jacobhuesman/Localization-Cape/README.md

# bbb_localization_cape
BeagleBone Black Cape for Localization Project
