jacobhuesman/Localization-Cape/eagle/localization-daughter-board.pdf

# Dynamixel LDO Microcontroller

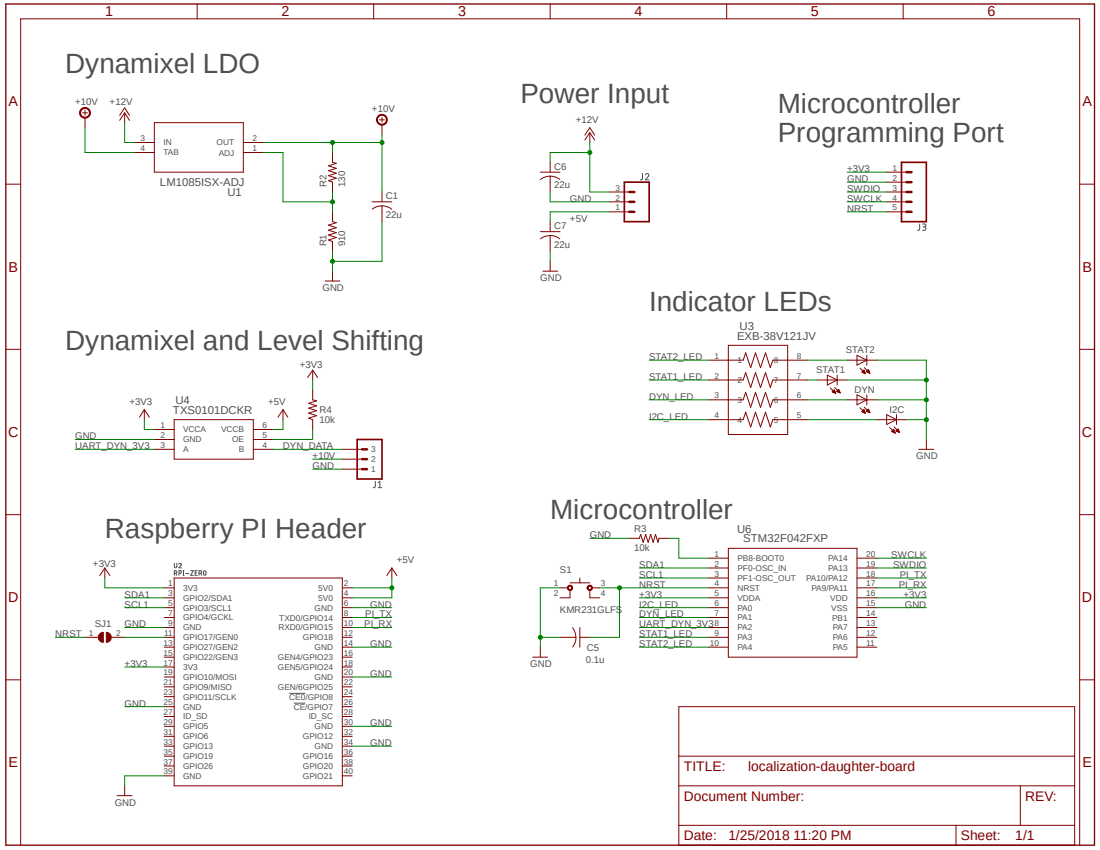
[picture p1: page 1]

Dynamixel and Level Shifting

Document Number: | REV:

Date: 1/25/2018 11:20 PM | Sheet: 1/1
