jacobhuesman/Localization-Cape/eagle/localization-daughter-board.brd

## EAGLE design eagle/localization-daughter-board.brd (2018-01-27)

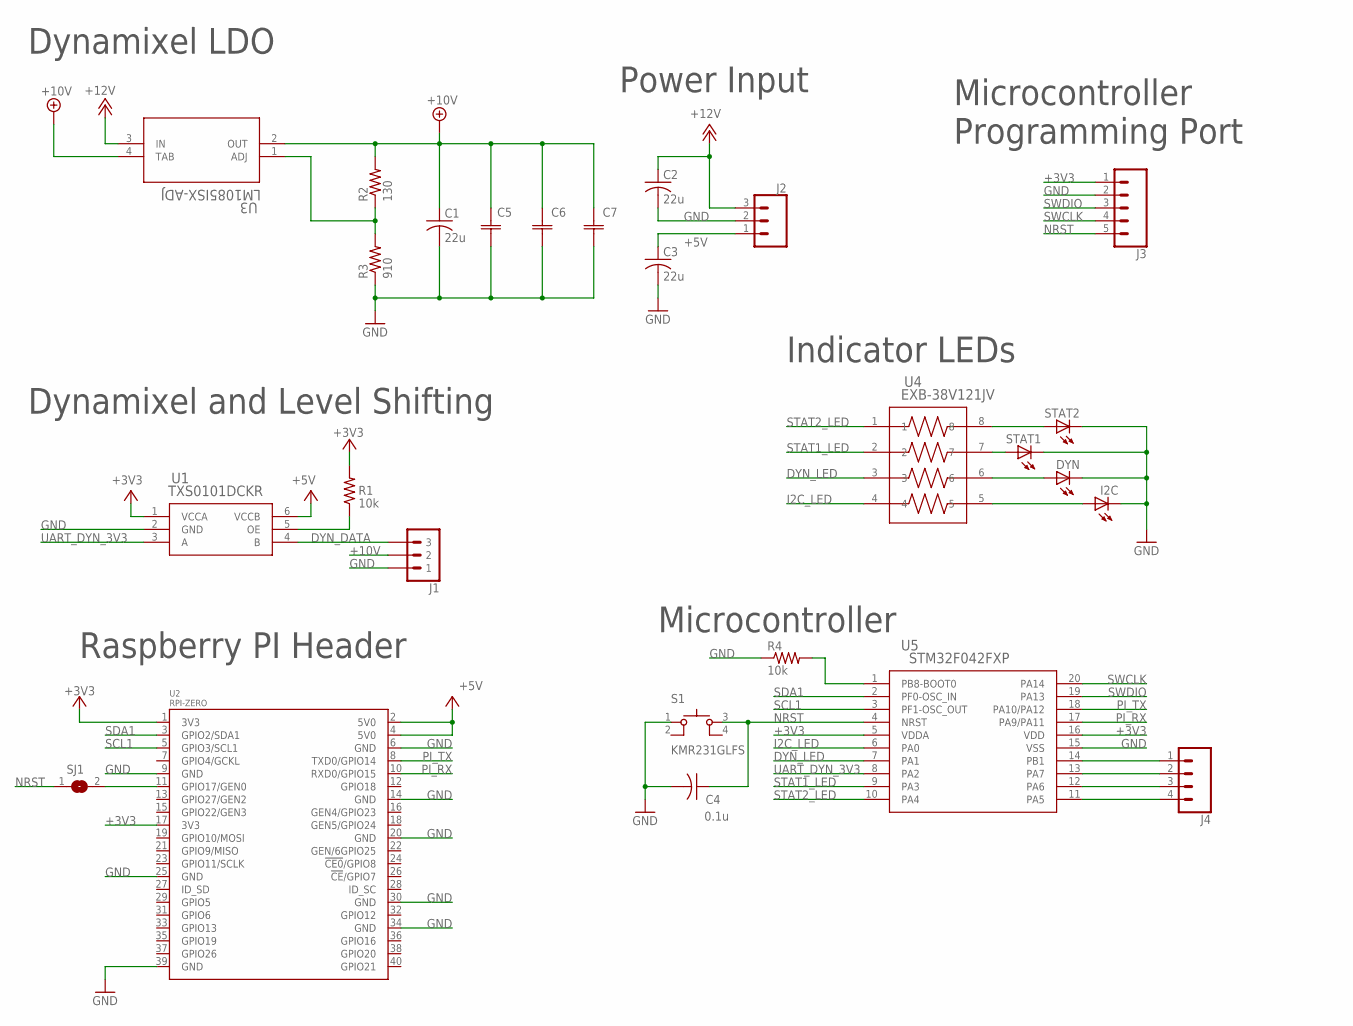
[picture p2: schematic localization-daughter-board.sch]

Parts:
C1: 22u; C1206
C2, C3: 22u; C0805
C4: 0.1u; C0805
C5, C6, C7: F931C107MCC; F93-C
DYN: LEDSML0603; SML0603
I2C: LEDSML0603; SML0603
J1: MOLEX-22-03-5035; MOLEX-22-05-7035
J2: CONN_03JST-PTH; JST-3-PTH
J3: CONN_05JST-VERT; JST-5-PTH-VERT
J4: CONN_041X04_NO_SILK; 1X04_NO_SILK
R1, R4: 10k; R0805
R2: 130; R0805
R3: 910; R0805
S1: KMR231GLFS
SJ1: SJ
STAT1, STAT2: LEDSML0603; SML0603
U1: TXS0101DCKR; DCK6
U2: RPI-ZERO; RASPBERRYPI_BASTELSTUBE_V13_RASPI_BOARD_B+_FULL
U3: LM1085ISX-ADJ; TS3B
U4: EXB-38V121JV; C_ARRAY_EXB38V
U5: STM32F042FXP; TSSOP20

Connections:
+3V3: J3.1, R1.2, U1.1 (VCCA), U2.1 (3V3), U2.17 (3V3), U5.5 (VDDA), U5.16 (VDD)
+5V: C3.1, J2.1, U1.6 (VCCB), U2.2 (5V0), U2.4 (5V0)
+10V: C1.1, C5.1, C6.1, C7.1, J1.P$2 (2), R2.2, U3.2 (OUT), U3.4 (TAB)
+12V: C2.1, J2.3, U3.3 (IN)
DYN_DATA: J1.P$3 (3), U1.4 (B)
DYN_LED: U4.3, U5.7 (PA1)
DYN_OE: R1.1, U1.5 (OE)
GND: C1.2, C2.2, C3.2, C4.2, C5.2, C6.2, C7.2, DYN.C, I2C.C, J1.P$1 (1), J2.2, J3.2, R3.1, R4.1, S1.1, STAT1.C, STAT2.C, U1.2 (GND), U2.6 (GND), U2.9 (GND), U2.14 (GND), U2.20 (GND), U2.25 (GND), U2.30 (GND), U2.34 (GND), U2.39 (GND), U5.15 (VSS)
I2C_LED: U4.4, U5.6 (PA0)
unnamed: R4.2, U5.1 (PB8-BOOT0)
unnamed: STAT1.A, U4.7
unnamed: R2.1, R3.2, U3.1 (ADJ)
unnamed: DYN.A, U4.6
unnamed: I2C.A, U4.5
unnamed: STAT2.A, U4.8
unnamed: J4.1, U5.14 (PB1)
unnamed: J4.2, U5.13 (PA7)
unnamed: J4.3, U5.12 (PA6)
unnamed: J4.4, U5.11 (PA5)
NRST: C4.1, J3.5, S1.3, SJ1.1, U5.4 (NRST)
PI_NRST: SJ1.2, U2.11 (GPIO17/GEN0)
PI_RX: U2.10 (RXD0/GPIO15), U5.17 (PA9/PA11)
PI_TX: U2.8 (TXD0/GPIO14), U5.18 (PA10/PA12)
SCL1: U2.5 (GPIO3/SCL1), U5.3 (PF1-OSC_OUT)
SDA1: U2.3 (GPIO2/SDA1), U5.2 (PF0-OSC_IN)
STAT1_LED: U4.2, U5.9 (PA3)
STAT2_LED: U4.1, U5.10 (PA4)
SWCLK: J3.4, U5.20 (PA14)
SWDIO: J3.3, U5.19 (PA13)
UART_DYN_3V3: U1.3 (A), U5.8 (PA2)

Notes on the sheet:
Dynamixel LDO
Dynamixel and Level Shifting
Microcontroller Programming Port
Raspberry PI Header
Microcontroller
Power Input
Indicator LEDs

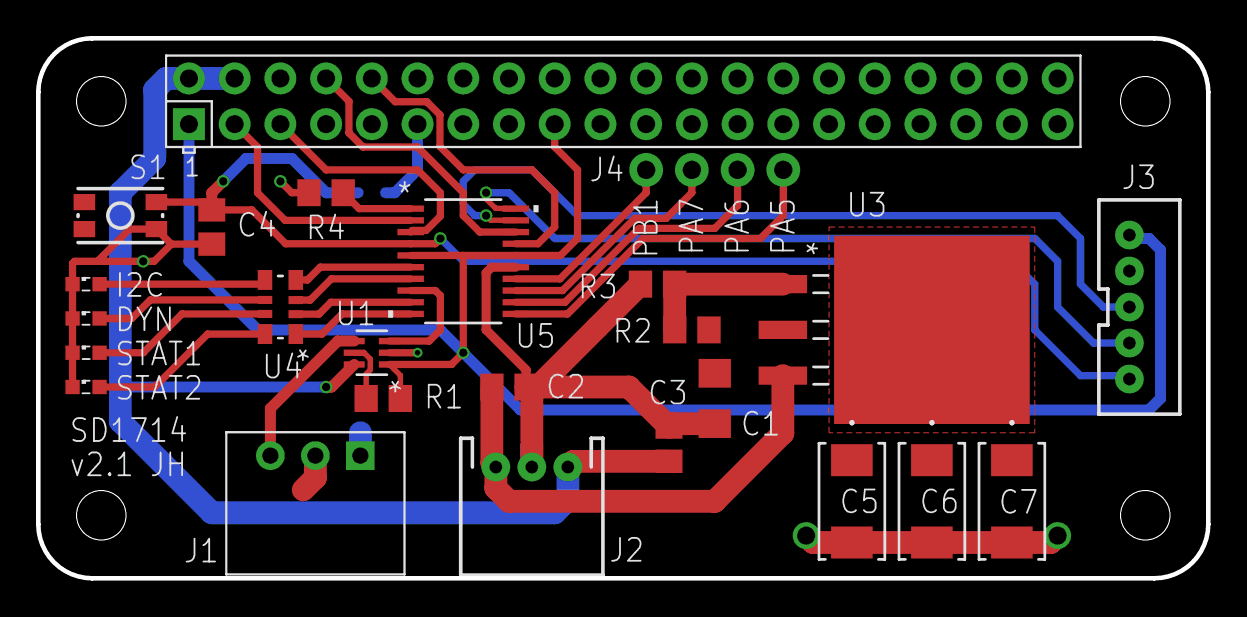
[picture p3: board localization-daughter-board.brd from above]

Board: 2 copper layers, 65.0 x 30.0 mm, 26 parts (1 on the bottom side), 30 nets.
