jacobhuesman/Localization-Cape/(threads)

Thread 1 (2017-10-25):

Reverse Polarity Protection

jacobhuesman, 2017-10-25:

jacobhuesman, 2017-11-16:
Added diode

Closed 2017-11-16.

Thread 2 (2017-10-25):

PowerDown Pin Conflicts with EMMC DAT0 Line

dashneptune, 2017-10-25:
This shouldn't be an issue for now, but we need to change the power down pin from being on P8.25 to being on P28.6 on the beaglebone side. We aren't using EMMC but we should probably change it to be compatible with Linux driver  in the future. Also, the DAT0 pin is the one that is used at startup for the thing, and its bidirectional, so we may cause issues with the output driver...

jacobhuesman, 2017-11-16:
Fixed

Closed 2017-11-16.

Thread 3 (2017-10-25):

Tristate Buffer

jacobhuesman, 2017-10-25:
The PRU pins used for reading in data from the camera are used in the boot-up sequence when running Linux on the BeagleBone Black. We need to put a Tristate Buffer in between the camera and the pins to prevent the camera from holding them low, which causes the BeagleBone to fail to boot.

jacobhuesman, 2017-11-16:
@dashneptune Looking at adding this buffer to the board:  SN74LVC16244ADGGR. Let me know if you think this is a good choice and suggestions on packaging.

jacobhuesman, 2017-11-17:
Only need the 8 data pins buffered, can go with a smaller chip.

Thread 4 (2017-10-25):

Different pad size needed for the 100uF capacitor

jacobhuesman, 2017-10-25:
Used the wrong pad size on this design, need to go with a larger pad size that can accommodate a 100uF capacitor.

jacobhuesman, 2017-11-16:
Changed to a Panasonic Type E capacitor

Closed 2017-11-16.

Thread 5 (2017-10-25):

XTAL for XCLK

dashneptune, 2017-10-25:
It may be prudent in a future revision to move to a crystal for for the clock on the ov7670/MT9V111. All of the cameras I've seen support a 24MHz crystal, which would have lower jitter. Also, it looks like the max I can do with the BBB is a 12 MHz without busting out one of the system clocks, which I'm looking at doing. We can probably use the system clock, I'll update this on my progress

dashneptune, 2017-10-28:
It looks like p9.25 can be used as a rough 24 Mhz clock...as long as gpio 1_27 is used as an output and brought high

dashneptune, 2017-10-28:
I'll try to pototype that this week

dashneptune, 2017-11-04:
Prototype is proven...We can use P9.25 for XCLK without utilizing any extra components

jacobhuesman, 2017-11-04:
Still need to implement on cape

jacobhuesman, 2017-11-16:
Done

Closed 2017-11-16.

Thread 8 (2017-11-28):

Pins for PRU UART

dashneptune, 2017-11-28:
We need to modify the UART pins to use the PRU's. I've gotten it workin  with pins p9.17 and p9.18. We also need to assign a pin to the direction. This is arbitrary but it  should be gottable by PRU0 on R30 (output register). The official names for the pins are pr1_uart0_txd and pr1_uart0_rxd. We need to figure out if these are in the pocketbeagle

dashneptune, 2017-11-28:
This should port to the pocket beagle. The corresponding pins on the OSD chip are B11 and A11. They are the I2C1 pins P2.9 and P2.11.
