jacobhuesman/Localization-Cape/(commit log)

2017-09-09 Started on cape
    [bbb_localization_cape.sch]
2017-09-16 Finished with DCDC converters and can transciever
    [bbb_localization_cape.brd, bbb_localization_cape.sch]
2017-09-16 Started on arducam device
2017-09-19 Almost done wiring camera
    [bbb_localization_cape.brd, bbb_localization_cape.sch]
2017-09-19 Decrusted the layout
    [bbb_localization_cape.brd, bbb_localization_cape.sch]
2017-09-19 Almost done with camera signals
    [bbb_localization_cape.brd, bbb_localization_cape.sch]
2017-09-20 Switched to ceramic capacitors
    [bbb_localization_cape.brd, bbb_localization_cape.sch]
2017-09-20 Finished camera connections
    [bbb_localization_cape.brd, bbb_localization_cape.sch]
2017-09-20 Added decoupling capacitors to each DC/DC converter input
    [bbb_localization_cape.brd, bbb_localization_cape.sch]
2017-09-20 Deleted redundant libraries and started on molex package
    [bbb_localization_cape.sch]
2017-10-07 Started adding the microcontroller
    [bbb_localization_cape.brd, bbb_localization_cape.sch]
2017-10-07 Added uart solder jumpers
    [bbb_localization_cape.brd, bbb_localization_cape.sch]
2017-10-07 Added power to MSP430
    [bbb_localization_cape.brd, bbb_localization_cape.sch]
2017-10-07 Consolidated libraries into bbb_cape_parts
    [bbb_localization_cape.brd, bbb_localization_cape.sch]
2017-10-07 Cleaned up schematic and board
    [bbb_localization_cape.brd, bbb_localization_cape.sch]
2017-10-07 Cleaning up schematic and board layout
    [bbb_localization_cape.brd, bbb_localization_cape.sch]
2017-10-07 Added frames
    [bbb_localization_cape.brd, bbb_localization_cape.sch]
2017-10-07 Laid out the board again
    [bbb_localization_cape.brd, bbb_localization_cape.sch]
2017-10-07 Almost finished with component layout
    [bbb_localization_cape.brd]
2017-10-07 More or less finished with the schematic and layout
    [bbb_localization_cape.brd, bbb_localization_cape.sch]
2017-10-07 Create ground plane
    [bbb_localization_cape.brd]
2017-10-07 Laid out power connections
    [bbb_localization_cape.brd, bbb_localization_cape.sch]
2017-10-07 Finished board layout
    [bbb_localization_cape.brd]
2017-10-08 Fixed issues between board and schematic, had to ripup the board
    [bbb_localization_cape.brd, bbb_localization_cape.sch]
2017-10-08 Cleaned up beaglebone_outline schematic symbol
    [bbb_localization_cape.brd, bbb_localization_cape.sch]
2017-10-08 Went over the entire schematic
    [bbb_localization_cape.brd, bbb_localization_cape.sch]
2017-10-08 Added components to deal with voltages during poweroff
    [bbb_localization_cape.brd, bbb_localization_cape.sch]
2017-10-09 Consolidated powerdown level shifters from 2 to 1
    [bbb_localization_cape.brd, bbb_localization_cape.sch]
2017-10-09 Added 10V and 5V lines
    [bbb_localization_cape.brd, bbb_localization_cape.sch]
2017-10-09 Most of components placed
    [bbb_localization_cape.brd, bbb_localization_cape.sch]
2017-10-09 Going to commit before I mess stuff up
    [bbb_localization_cape.brd]
2017-10-10 Laid out most of camera module traces
    [bbb_localization_cape.brd, bbb_localization_cape.sch]
2017-10-10 Just checking in
    [bbb_localization_cape.brd]
2017-10-10 Done for the night
    [bbb_localization_cape.brd]
2017-10-10 Fixed the PTH mistakes
    [bbb_localization_cape.brd]
2017-10-10 Passing ERC, still need to go through DRC
    [bbb_localization_cape.brd, bbb_localization_cape.sch]
2017-10-10 Finished routing signals, passing ERC and DRC
    [bbb_localization_cape.brd, bbb_localization_cape.sch]
2017-10-10 Labeled everything
    [bbb_localization_cape.brd, bbb_localization_cape.sch]
2017-10-10 Done, needs external review
    [bbb_localization_cape.brd, bbb_localization_cape.sch]
2017-10-10 Updated schematic
2017-10-10 Added ground plane
    [bbb_localization_cape.brd]
2017-10-11 Added power planes
    [bbb_localization_cape.brd]
2017-10-11 Began adding 3D models of components
    [bbb_localization_cape.brd, bbb_localization_cape.sch]
2017-10-12 Almost done adding 3D models
    [bbb_localization_cape.brd, bbb_localization_cape.sch]
2017-10-13 Finished BOM
    [bbb_localization_cape.brd, bbb_localization_cape.csv, bbb_localization_cape.sch, bom.xlsx]
2017-10-24 Updated pdf and other things
    [bbb_localization_cape.brd, bbb_localization_cape.csv, bbb_localization_cape.sch, bom.xlsx, bom_digikey.xlsx]
2017-11-16 Changed board part from Adafruit to Sparkfun version
    [bbb_localization_cape.brd, bbb_localization_cape.sch]
2017-11-16 Finished changing cape style
    [bbb_localization_cape.brd, bbb_localization_cape.sch]
2017-11-16 Added reverse current protection and changed PWDN pin
    [bbb_localization_cape.brd, bbb_localization_cape.sch]
2017-11-16 Changed XCLK
    [bbb_localization_cape.brd, bbb_localization_cape.sch]
2017-11-16 Added dimension layer
    [bbb_localization_cape.brd, bbb_localization_cape.sch]
2017-11-16 Fixed GND path
    [bbb_localization_cape.brd]
2017-11-16 Updated 3D models
    [bbb_localization_cape.brd, bbb_localization_cape.sch]
2017-11-16 Started on buffer
    [bbb_localization_cape.brd, bbb_localization_cape.sch]
2017-11-18 Started on v2.0
    [PocketBeagle.brd, PocketBeagle.sch, PocketBeagle.step, PocketBeagleCape.brd, PocketBeagleCape.sch, PocketBeagle_BOM.csv, bbb_localization_cape.csv, bom.xlsx]
2017-11-18 Removed pocket_beagle repo files
    [PocketBeagle.brd, PocketBeagle.sch, PocketBeagle.step, PocketBeagleCape.brd, PocketBeagleCape.sch, PocketBeagle_BOM.csv, bbb_localization_cape.brd, bbb_localization_cape.sch]
2017-12-11 Started on new board
    [PocketBeagleCape.brd, PocketBeagleCape.sch, bbb_localization_cape.brd, bbb_localization_cape.sch, localization-daughter-board.brd, localization-daughter-board.sch]
2017-12-11 Just saving progress
    [localization-daughter-board.brd, localization-daughter-board.sch]
2017-12-11 Finished initial schematic
    [localization-daughter-board.brd, localization-daughter-board.sch]
2017-12-11 Fixed dynamixel connections
    [localization-daughter-board.brd, localization-daughter-board.sch]
2017-12-11 Finished initial power layout
    [localization-daughter-board.brd, localization-daughter-board.sch]
2017-12-11 Finished initial design
    [localization-daughter-board.brd, localization-daughter-board.sch]
2017-12-11 Removed redundant pull-up resistor
    [localization-daughter-board.brd, localization-daughter-board.sch]
2017-12-11 Finished board
    [localization-daughter-board.brd]
2017-12-18 Updated schematic and BOM
    [bom.xlsx, localization-daughter-board.brd, localization-daughter-board.sch]
2018-01-26 Added most of the new components
    [localization-daughter-board.brd, localization-daughter-board.sch]
2018-01-26 Finished layout, need to do final check
    [localization-daughter-board.brd, localization-daughter-board.sch]
2018-01-26 Fixed a few nasty traces and did ERC and DRC
    [localization-daughter-board.brd]
2018-01-26 Added a few comments to the schematic
    [localization-daughter-board.sch]
2018-01-26 Removed extra files and updated pdf
    [PocketBeagleCape.brd, PocketBeagleCape.sch, bbb_localization_cape.brd, bbb_localization_cape.sch, bom.xlsx, localization-daughter-board.sch]
2018-01-26 Broke out the rest of the micro pins. Adjusted the font on connectors
    [localization-daughter-board.brd, localization-daughter-board.sch]
2018-01-27 Fixed fonts again
    [localization-daughter-board.brd]
2018-01-27 Current design
    [localization-daughter-board.brd, localization-daughter-board.sch]
2018-01-27 Added additional capacitors
    [localization-daughter-board.brd, localization-daughter-board.sch]
